M17-Project/rru2-rf-sx1255/rru2-rf-sx1255.kicad_pcb

## KiCad design rru2-rf-sx1255.kicad_pcb (2026-10-22)

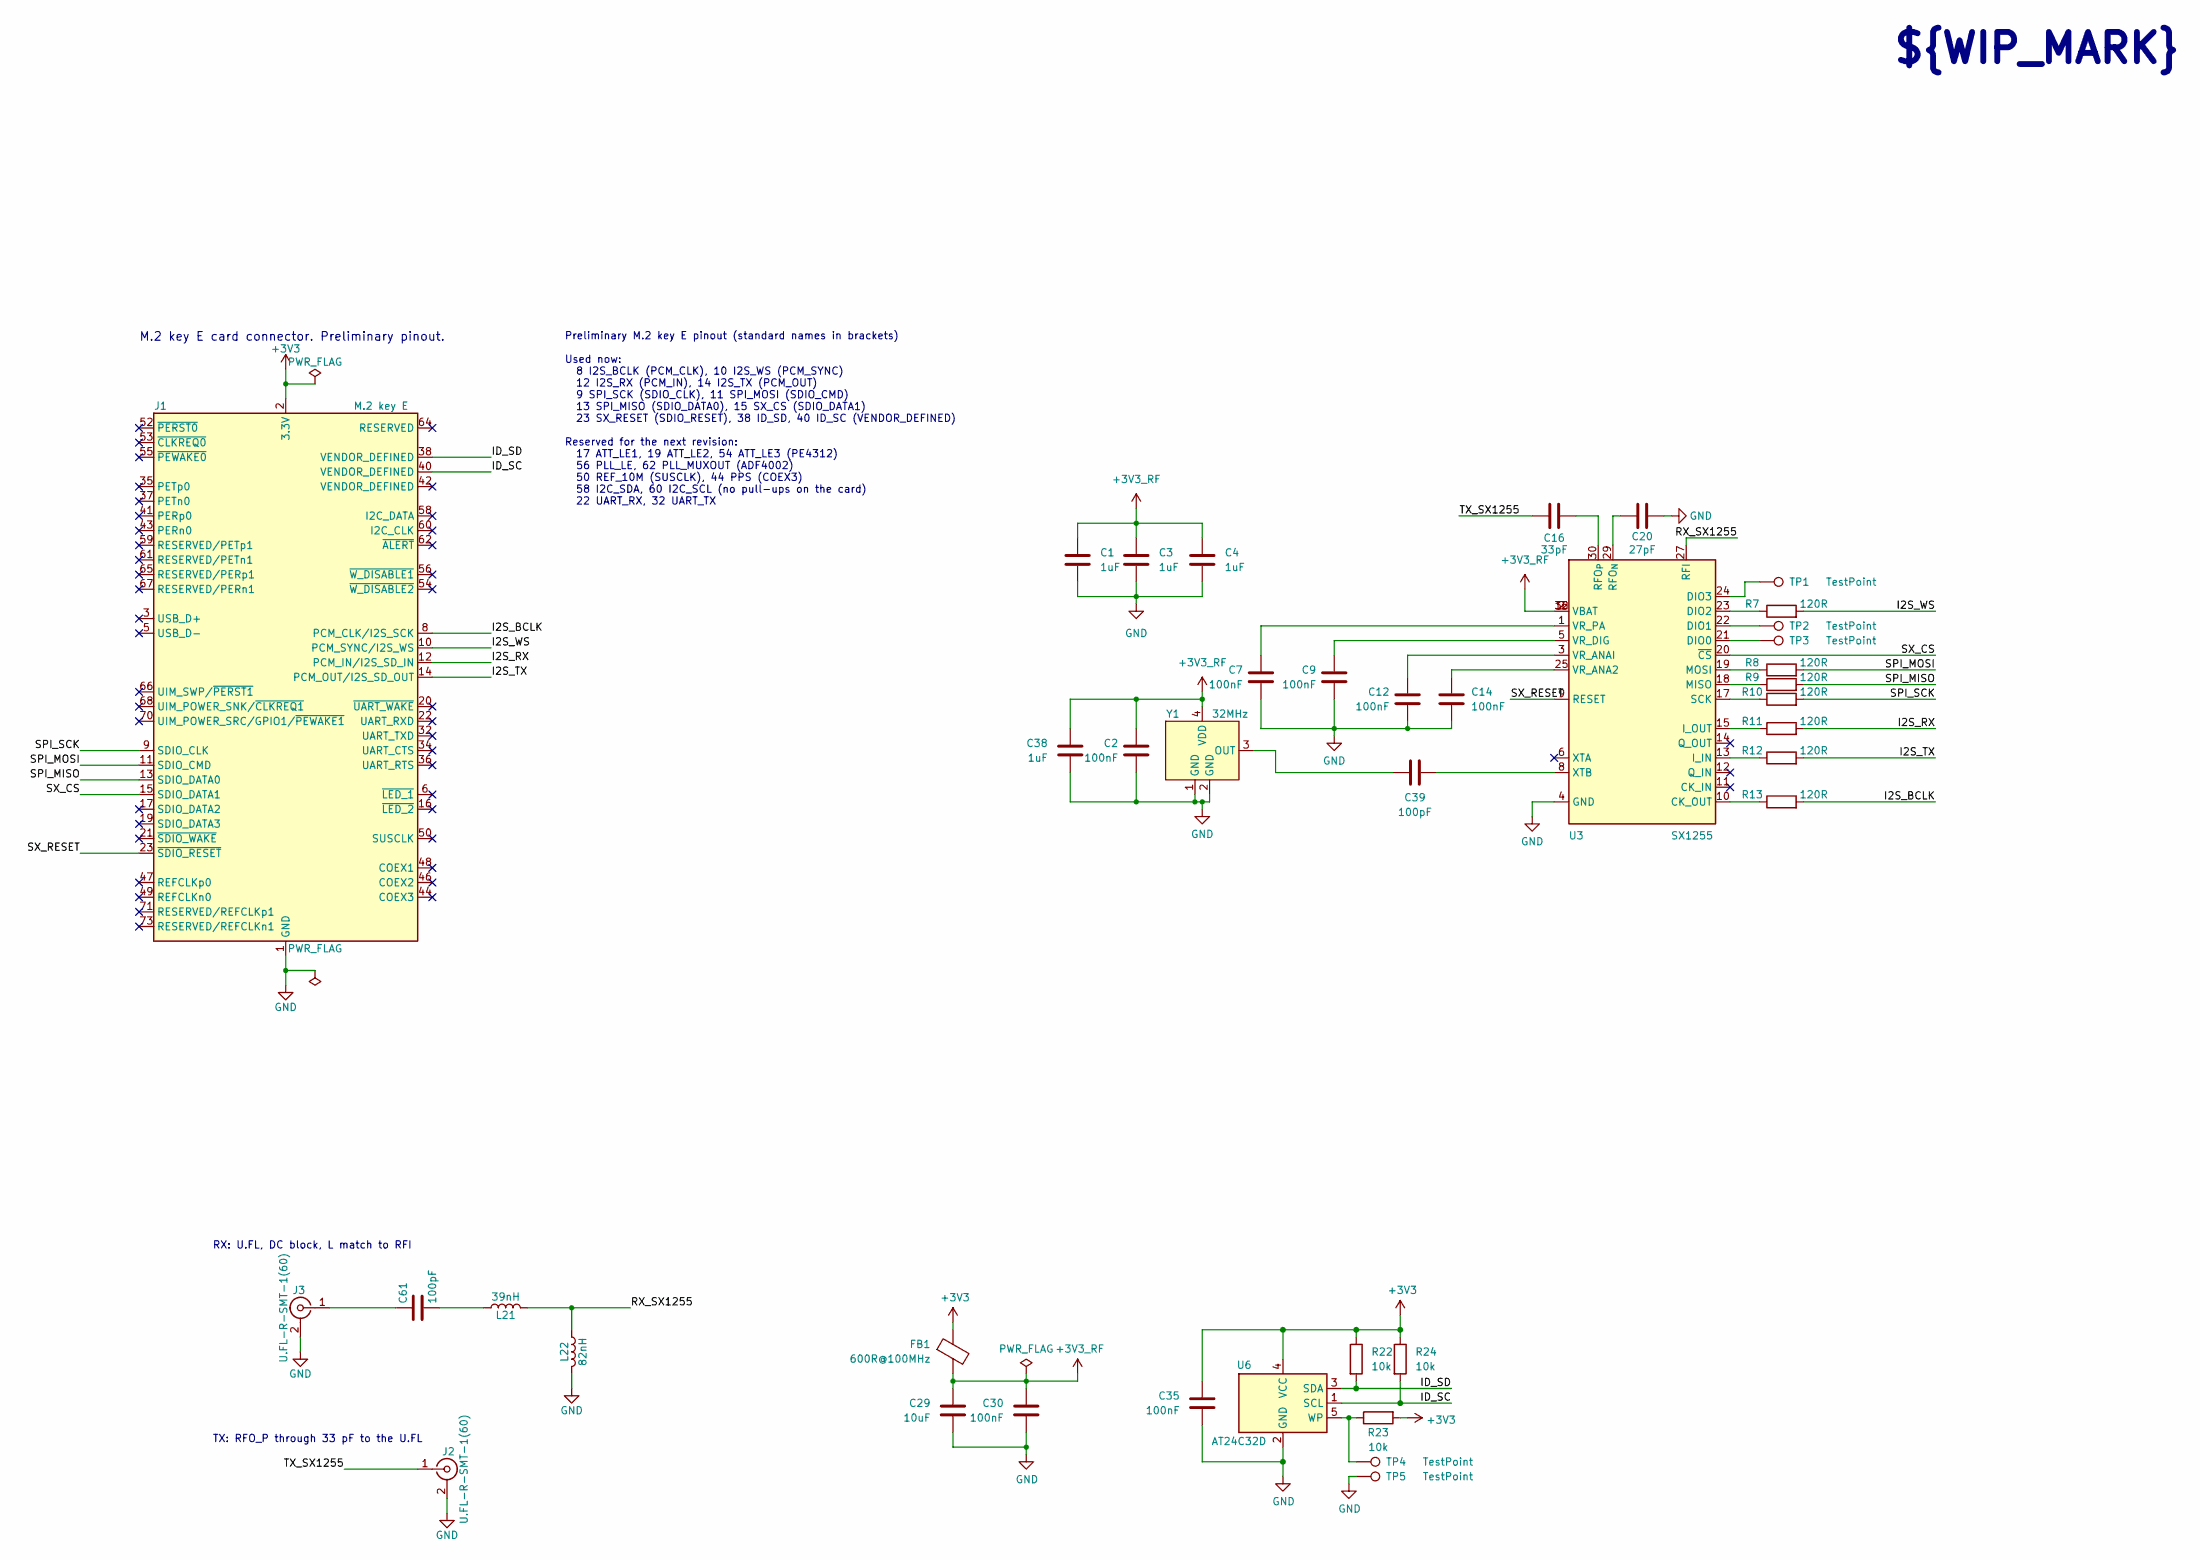
[picture p1: schematic rru2-rf-sx1255.kicad_sch, RRU2 RF SX1255]

Parts:
C1, C3, C4, C38: 1uF; C_0402_1005Metric; Tolerance ±10%; Voltage 25V; MPN CL05A105KA5NQNC; Mouser 187-CL05A105KA5NQNC
C2, C7, C9, C12, C14, C30, C35: 100nF; C_0402_1005Metric; Tolerance ±10%; Voltage 50V; MPN CL05B104KB54PNC; Mouser 187-CL05B104KB54PNC
C16: 33pF; C_0402_1005Metric; Tolerance ±1%; Voltage 50V; MPN GJM1555C1H330FB01D; Mouser 81-GJM1555C1H330FB1D
C20: 27pF; C_0402_1005Metric; Tolerance ±1%; Voltage 50V; MPN GJM1555C1H270FB01D; Mouser 81-GJM1555C1H270FB1D
C29: 10uF; C_0805_2012Metric; Tolerance ±10%; Voltage 50V; MPN CL21A106KBYQNNE; Mouser 187-CL21A106KBYQNNE
C39, C61: 100pF; C_0402_1005Metric; Tolerance ±2%; Voltage 100V; MPN GCM1555C2A101GE02D; Mouser 81-GCM1555C2A101GE2D
FB1: 600R@100MHz; L_0402_1005Metric; Tolerance ±25%; MPN BLM15PX601SN1D; Mouser 81-BLM15PX601SN1D
J1: M.2 key E; M.2_2230-xx-E
J2, J3: U.FL-R-SMT-1(60); U.FL_Hirose_U.FL-R-SMT-1_Vertical; MPN U.FL-R-SMT-1(60); Mouser 798-UFLRSMT160
L21: 39nH; L_0402_1005Metric; Tolerance ±2%; MPN LQW15AN39NG00D; Mouser 81-LQW15AN39NG00D
L22: 82nH; L_0402_1005Metric; Tolerance ±2%; MPN LQW15AN82NG00D; Mouser 81-LQW15AN82NG00D
R7, R8, R9, R10, R11, R12, R13: 120R; R_0402_1005Metric; Tolerance ±1%; Voltage 50V; MPN 0402WGF1200TCE; Mouser 303-0402WGF1200TCE
R22, R23, R24: 10k; R_0402_1005Metric; Tolerance ±1%; Voltage 50V; MPN 0402WGF1002TCE; Mouser 303-0402WGF1002TCE
TP1, TP2, TP3, TP4, TP5: TestPoint; TestPoint_Pad_D1.0mm
U3: SX1255; QFN-32-1EP_5x5mm_P0.5mm_EP3.3x3.3mm_ThermalVias; Mouser Part Number 947-SX1255IWLTRT
U6: AT24C32D; SOT-23-5; MPN AT24C32D-STUM-T; Mouser 556-AT24C32D-STUM-T
Y1: 32MHz; Crystal_SMD_2016-4Pin_2.0x1.6mm; MPN ECS-TXO-20CSMV4-320-AY-TR; Mouser 520-TX20CSMV4320AYTR

Connections:
+3V3: C35.1, FB1.1, J1.2 (3.3V), J1.4 (3.3V), J1.72 (3.3V), J1.74 (3.3V), R22.1, R23.2, R24.1, U6.4 (VCC)
+3V3_RF: C1.1, C2.1, C3.1, C4.1, C29.1, C30.1, C38.1, FB1.2, U3.2 (VBAT), U3.16 (VBAT), U3.32 (VBAT), Y1.4 (VDD)
/I2S_BCLK: J1.8 (PCM_CLK/I2S_SCK), R13.2
/I2S_RX: J1.12 (PCM_IN/I2S_SD_IN), R11.2
/I2S_TX: J1.14 (PCM_OUT/I2S_SD_OUT), R12.2
/I2S_WS: J1.10 (PCM_SYNC/I2S_WS), R7.2
/ID_SC: J1.40 (VENDOR_DEFINED), R24.2, U6.1 (SCL)
/ID_SD: J1.38 (VENDOR_DEFINED), R22.2, U6.3 (SDA)
/RX_SX1255: L21.2, L22.1, U3.27 (RFI)
/SPI_MISO: J1.13 (SDIO_DATA0), R9.2
/SPI_MOSI: J1.11 (SDIO_CMD), R8.2
/SPI_SCK: J1.9 (SDIO_CLK), R10.2
/SX_CS: J1.15 (SDIO_DATA1), U3.20 (~CS)
/SX_RESET: J1.23 (~SDIO_RESET), U3.9 (RESET)
/TX_SX1255: C16.1, J2.1 (In)
GND: C1.2, C2.2, C3.2, C4.2, C7.2, C9.2, C12.2, C14.2, C20.2, C29.2, C30.2, C35.2, C38.2, J1.1 (GND), J1.7 (GND), J1.18 (GND), J1.33 (GND), J1.39 (GND), J1.45 (GND), J1.51 (GND), J1.57 (GND), J1.63 (GND), J1.69 (GND), J1.75 (GND), J2.2 (Ext), J3.2 (Ext), L22.2, TP5.1 (1_1), U3.4 (GND), U3.7 (GND), U3.26 (GND), U3.28 (GND), U3.31 (GND), U3.33 (GND), U6.2 (GND), Y1.1 (GND), Y1.2 (GND)
unnamed: C61.2, L21.1
unnamed: C61.1, J3.1 (In)
unnamed: R13.1, U3.10 (CK_OUT)
unnamed: TP3.1 (1_1), U3.21 (DIO0)
unnamed: TP2.1 (1_1), U3.22 (DIO1)
unnamed: R7.1, U3.23 (DIO2)
unnamed: TP1.1 (1_1), U3.24 (DIO3)
unnamed: R12.1, U3.13 (I_IN)
unnamed: R11.1, U3.15 (I_OUT)
unnamed: R9.1, U3.18 (MISO)
unnamed: R8.1, U3.19 (MOSI)
unnamed: C20.1, U3.29 (RFO_{N})
unnamed: C16.2, U3.30 (RFO_{P})
unnamed: R10.1, U3.17 (SCK)
unnamed: C14.1, U3.25 (VR_ANA2)
unnamed: C12.1, U3.3 (VR_ANAI)
unnamed: C9.1, U3.5 (VR_DIG)
unnamed: C7.1, U3.1 (VR_PA)
unnamed: C39.1, U3.8 (XTB)
unnamed: R23.1, TP4.1 (1_1), U6.5 (WP)
unnamed: C39.2, Y1.3 (OUT)

Notes on the sheet:
Preliminary M.2 key E pinout (standard names in brackets) Used now: 8 I2S_BCLK (PCM_CLK), 10 I2S_WS (PCM_SYNC) 12 I2S_RX (PCM_IN), 14 I2S_TX (PCM_OUT) 9 SPI_SCK (SDIO_CLK), 11 SPI_MOSI (SDIO_CMD) 13 SPI_MISO (SDIO_DATA0), 15 SX_CS (SDIO_DATA1) 23 SX_RESET (SDIO_RESET), 38 ID_SD, 40 ID_SC (VENDOR_DE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
M.2 key E card connector. Preliminary pinout.
TX: RFO_P through 33 pF to the U.FL
${WIP_MARK}
RX: U.FL, DC block, L match to RFI

Board: 4 copper layers, 40 parts (0 on the bottom side), 37 nets, no tracks yet.
