M17-Project/rru2-rf-sx1255/(commit log)

2026-10-22 Add the KiCad 10 project, README and license
    [rru2-rf-sx1255.kicad_pcb, rru2-rf-sx1255.kicad_sch]
2026-10-22 Add a preliminary M.2 2230 key E board outline
    The outline is a copy of the KiCad footprint Connector_PCBEdge:M.2_2230-xx-E. The card size is not decided yet.
    [rru2-rf-sx1255.kicad_pcb]
2026-10-22 Remove the LDO from the block diagram
    The mainboard supplies a stable 3.3 V through the M.2 connector.
2026-10-22 Add output power specification to README
2026-10-22 Add the basic SX1255 schematic and the footprints
    - The SX1255 block, the ferrite bead supply and the ID EEPROM use the
    circuit of the SX1255 HAT: decoupling, TCXO clock into XTB, series
    resistors on SPI and I2S, test points on DIO0, DIO1 and DIO3.
    - RX: U.FL, DC block and L match to RFI. TX: RFO_P through 33 pF to U.FL.
    - Preliminary M.2 key E pinout (text on the schematic).
    - Authors in the title blocks.
    - The footprints are on the board. They are not placed and not routed.
    - The board is marked as work in progress (KiCad text variable WIP_MARK).
    [rru2-rf-sx1255.kicad_pcb, rru2-rf-sx1255.kicad_sch]
2026-10-22 Add the KiCad footprint libraries to the project library table
    The CI container has no global library table. The library submodule now
    writes the KiCad footprint libraries into fp-lib-table.
2026-10-22 Update the library
    The library now writes the KiCad footprint libraries into fp-lib-table
    (M17-Project/M17_kicad_library#4).
